Nesse1/VP-Compressor-controller/README.md

# Volvo Penta Compressor Controller
For reading tach signal from generator with microcontroller and with this set status on/off for compressor

## Why I started this project:

My Sealine F37 cabin cruiser has two Volvo Penta KAMD/KAD 43 engines with turbo intercoolers & compressor. Compressors primary use is for boat to easier reach/pass planning threshold. The compressor activates electronically when rpm is between 1600 & 2400 rpm, and this is not always a good thing.
When I am lowering speed/rpm and are slowing down they also activate from 2400 to 1600 rpm, this is not necessary. Also, if I want to cruise at a lower speed where rpm is between 1600-2400rpm I do not want them to be active. This is the first code/sketch I have written from scratch, so I guess there is potential for improvement, but it works as intended so I am happy about it.

The reason for why I do not want the compressors to be active in these situations: 

  1 - Unnecessary wear - Repeating activation/deactivation of compressors means unnecessary wearing of the clutch and drive belt. Also cruising with compressor active means an hi loading pressure of air to engines which is unnecessary wear of engine.
  
  2 - Noise   
Compressors activates as mentioned by an electrical signal, so there is a common solution among boatowners to mount a switch and relay to isolate this signal so they can run engines without compressors active. I ‘we have heard that Volvo recommends this, but what do I know. 
I thought of mounting a switch & relay, but I ‘we always meant that anything worth doing is worth overdoing.... 

## First a look at the signal I want to read:

Searching through manuals for generator and tachometer i found this table in an .pdf installation guide:

Table of VP engines

Following the column for Marine Engines I found my engine (31-43) and the conversion factor of 14,7. So then I found that the signal from generators face W should be 14,7 "triggers" per engine revolution.

## Calculations: 
I´m building the code using the command "pulseIn" which returns how many microseconds pulse is defined HIGH or LOW. Then we must do some calculations in code to get rpm.

How does the range of pulses/min from my engine looks:

  Number of pulses/min at idle or 750/rpm:             750 * 14,7 = 11025 pulses/min at 750 rpm  
  Number of pulses/min at mid throttle or 2500/rpm    2500 * 14,7 = 36750 pulses/min at 2500 rpm  
  Number of pulses/min at full throttle or 3900/rpm:  3900 * 14,7 = 57330 pulses/min at 3900 rpm  

How many pulses/second pr engine shaft revolution:

  Number of pulses/second at idle or 750/rpm:           11025 / 60 = 183,75 Hz or pulses/sec  
  Number of pulses/second at mid throttle or 2500/rpm   36750 / 60 = 612,5 Hz or pulses/sec  
  Number of pulses/second at full throttle or 3900/rpm: 57330 / 60 = 955,5 Hz or pulses/sec  
  
How many microseconds from start to end of pulse (HIGH & LOW):
  
   Length pulse at idle or 750/rpm:                       1000000 / 183,75 = 5442 micros  
  Length pulse at mid throttle or 2500/rpm:              1000000 / 612,5  = 1633 micros  
  Length pulse at full throttle or 3900/rpm:             1000000 / 955,5  = 1047 micros  

### Some issues:
At first I assumed that signals Voltage would be about 14 V as this is the voltage usually delivered from generators, but after playing around with the code and an voltage divider and just getting strange rpm readings, I found that connecting an oscilloscope was necessary. This reviled that there is a stabile 12 Voltage signal and I had to change resistors in my voltage divider. Furthermore, this signal has some interference.
In my microcontroller code I use the pulseIn function to read how many microseconds pulse is high, then also to read microsecond pulse is low an adding them both together for finding pulse high-low length. Total length of pulse is then used to calculate rpm. The interference has some ripples that are pulling the pulse to LOW and this is then of course messing with my code calculations.  
I don´t have the actual readings, but to give U an idea they look something like this:  
Example of pulse noice

Example shows a good pulse at 750 rpm to the left and a bad pulse to the right. With calculations in code result will show 750 rpm for the first pulse, but the second pulse with one ripple in it will deliver an LOW reading mid pulse. "Bad" pulses have of course often several ripples, this is just an example. 

I´m using an Wemos D1 mini board for this project because I suspect that in the future, I want a mesh network of these boards in my boat for controlling several stuffs. This board has as i found from 2,6 to 3.3 Voltage tolerance for input signal, so voltage divider must be pretty accurate. There is a while since I ‘we used and build filters for signals so my probably rubbish attempt to passive filter the signal with a small capacitor wasn´t any good. Result was good signal at low rpm (from 750 to about 1000) but higher rpm also means higher frequency of pulse and voltage dropped therefore below 2,6 and no signals got registered by the card. I´m sure there is a good way to "polish" the signal, so this issue disappears, but my way around it was some coding that specify an allowance of length of pulse High & Low, and this seems to work well. If U got a drawing of a filter that would do a good job I´m interested :-).
The solution for this to work without filtering of frequency was to alter the code so it´s only uses pulses that are within normal range of engine.
The pulse reading in code happens using microseconds, ore 1/1000000 second if U will. This happens fast, so the process must be slowed down before an output. I´m using an Array to get a pulse length average of rpm readings, and further using an Array again to get an rpm average for Status updates. This slows the process down and helps to get a smoother and more correct output.

## Tachometerread.ino

Tachometerread.ino contains just the code for reading tach signal and outputs rpm on serial, I added this as a tach read only with thoughts that this could be the interesting part for some users. You will find a lot of comments at each section in the code, so here I am just focusing on the parts U might want to change. 

### Things you might have to change in code:

Number of readings for pulse average for smoother rpm reading:
```

const int numReadings = 200;    // How many pulses u calculate average from, I found that 200 still updates fast enough

```

How many pulses should you calculate average from? Higher number gives smooth readings/slower updates of rpm and lower number gives a more "jumping" reading but faster updates. One pulse duration is at most (for my engine) 5442 micros, which means that slowest pulse rate is 183,75 pulses in second (if all pulses are good and without ripples) so 200 pulses isn´t as much as it seems.

Input Pin:
```

int tachoinputPin = 5;          // Specify pin for input signal from generator

```

Specify digital pin for where you connect the positive signal wire from tachometer signal, negative signal wire connects to ground. If you do not have negative signal wire i guess you will have to connect microcontroller 5V negative to engine 12 V negative.

Values U must change according to your engine:
```

int pulsesPerRev = 147;         // 14.7 * 10 (so we include desimal after dot) - Factor for calculating, number of pulses from generator pr engine revolution 
int correctingRev = 20;         // For eventual correction of output rpm, i found that 20 (2.0%) gives me more acurate readings according to tachometer in boat.

```
PulsesPerRev is where U specify how many pulses Your generator is delivering per revolution. As U can see U have to multiply pulses per revolution by 10, this was necessary for code to also consider decimals behind dot.

CorrectingRev is a function added for ability to adjust rpm readings if they don´t match tachometer. 20 = 2 % higher value output.

Allowance of pulse:

```

int lowestPulseAllowed = 900;  // Lowes pulse allowed - At 3900 rpm pulse is 1047 micros, so shorter pulses are most lightly ripples
int highestPulseAllowed = 6000; // Highest pulse allowed - At 750 rpm pulse is 5442 micros, so longer pulses are most lightly ripples

```
I discovered that counting pulses in microseconds like I do in this code will also count all kind of noise. Some of this noise brings the pulse to low several times while pulse is supposed to be high. Therefore, by adding an allowance limit for pulses to be read I manages to filter out most of the bad pulses. Also, since the normal length of pulses is so short that I measure them in microseconds i find that there is plenty of "good" pulses to get the reading fast enough.
U will have to do some calculations like mine to find your needs for allowance. Notice that I´m setting allowance a bit higher/lower than actual calculations.

Connections:

Connections

Microcontroller used is Wemoa D1 mini, but any controller should work. As mentioned, knowing myself I will probably want to send data over mesh network later so i might as well start with a microcontroller like this. In the voltage divider I am using resistor R1 = 5,6K and R2 = 2,2K. This microcontroller has a tolerance for digital high in from 2,6 to 3,3V. This voltage divider gives me an signal with high voltage at 3,5-3,6 volt, this is a bit higher than tolerance, but this works well for now without issues, if this later on should be an problem I will have to use another configuration of resistors.   
Card is here powered from PC and PC is used for reading serial data.

## OneEngineCompressorController.ino

With a reading of rpm from engine it is time to use this for controlling compressor. This code is of course based on and an continue of TachometerRead.ino, therefore I will only comment on the new lines in this code.

### What code does:

In this code I am using rpm readings to calculate a status for the rpm. My goal is to get a status (3) when rpm is increasing, an status (1) when rpm is decreasing and an status (2) when rpm is stabile over an certain time. With this status I can control a relay to close when I want compressor to be active when we have increasing rpm, and inactive when rpm i stabile or decreasing.

### Things U might want to change in this code:

Array for statusupdate

```

const int numReadingsRpm_Engine1Stat = 100;    // How many rpm u calculate average for statusupdate from

```
I am using an Array to get an average reading of statusupdates, this to slow down and stabilize updates so status is less jumping. 

Status Delay:
```

const int StatusDelay_Engine1 = 5000;         // Set an delay in millis for status to change, this delay avoids compressor for rapidly turning on/off

```

I am setting a delay for status updates, this is also for avoiding status to jump around. This function will check averagestatus and wait 5000 millis (5 seconds), then check averagestatus again before changing the rpmEngine_1Status output.
This will also mean that if I increase throttle from idle to 2000rpm stabile, it will take 5 seconds before compressor is deactivated.

Some values U might want to change:

```

int relayoutputPinEngine_1 = 2;            // Specify pin for output signal to relay
int ledPinGreenEngine_1 = 0;           //Used for debugging and for testing status when connected to engine, defines pin used for led
int ledPinRedEngine_1 = 4;             //Used for debugging and for testing status when connected to engine, defines pin used for led

```
I have added input pin for relay, red and green led, i guess relay and led output pins are self-explaining.  

Connections:

Connections

Resistors for voltage divider is still the same, R1 = 5.6K and R2 = 2.2K. Resistors R3 & R4 used for led is 220 ohms.
The compressor is connected to the relay´s "closed" connection so that when power is added to relay it breaks the circuit for power to compressor.
I have also added a 5 volt voltage regulator, I didn´t have an 3,3 but this works fine as long as i power the Wemos board using 5V pin...

Video where I am testing status updates in boat:
https://youtu.be/avVuPIPxaBE

Using led for testing status is useful for seeing what and when things are happening. At this point it is also useful to play around with some parameters to fully understand what happens: 

```
//For smoother rpmEngine_1 value
const int numReadingsRpm_Engine1 = 200;        // How many pulses u calculate rpm average from, i fond that 200 still updates fast enough
const int numReadingsRpm_Engine1Stat = 100;    // How many rpm u calculate average for statusupdate from
const int StatusDelay_Engine1 = 5000;         // Set an delay in millis for status to change, this delay avoids compressor for rapidly turning on/off

int correctingRevEngine_1 = 20;             // For eventual correction of output rpm, i found that 20 (2.0%) gives me more accurate readings according to tachometer in boat.

// Pulse signal from generator is full of ripples, so by setting max/min pulse allowed code will only read relevant and "clean" pulses.
int lowestPulseAllowedEngine_1 = 900;      // Lowes pulse allowed - At 3900 rpm pulse is 1047 micros, so shorter pulses are most lightly ripples or an incorrect pulse
int highestPulseAllowedEngine_1 = 5800;     // Highest pulse allowed - At 750 rpm pulse is 5442 micros, so longer pulses are most lightly ripples or an incorrect pulse

```

When you are happy with result, it is time to perform full test:

https://youtu.be/tlZVmXCEPew

After performing full test, I found that there is still some adjustments I want to do:
increasing tolerance for rpm +/- for status since engine changes status when idle and when Status = 2 (rpm stabile) at 2000 rpm since rpm rises a bit when compressor is disengaging.
Change some timing issues, I want to try to lower delay for status update and add to code that compressor does not have to engage if Status = 2 (rpm stabile) and rpm is above 2000. This will avoid compressor to start up just for a second or two.... 

Final test after changes:

https://youtu.be/Tseec64TGQg

Now I am happy, all functions work as intended and I am ready for mounting controller and relays in waterproof box for final installation.
I will add some pictures when done :-)
